Phil-obed/Industrial-Inspection-Bot/Programs/Dashboard/images/image.png

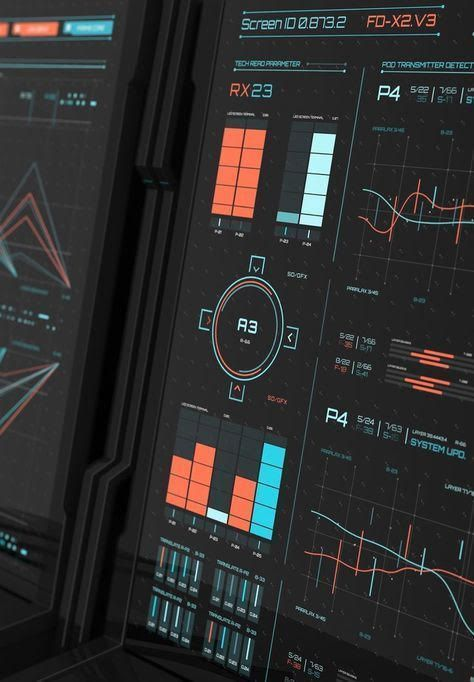
Programs/Dashboard/images/image.png
