Phil-obed/Industrial-Inspection-Bot/README.md

download TINYGPS++ library for successful compilation
