Phil-obed/Industrial-Inspection-Bot/Documents/COVER.docx

University of Energy and Natural Resources

Department of Computer and Electrical Engineering

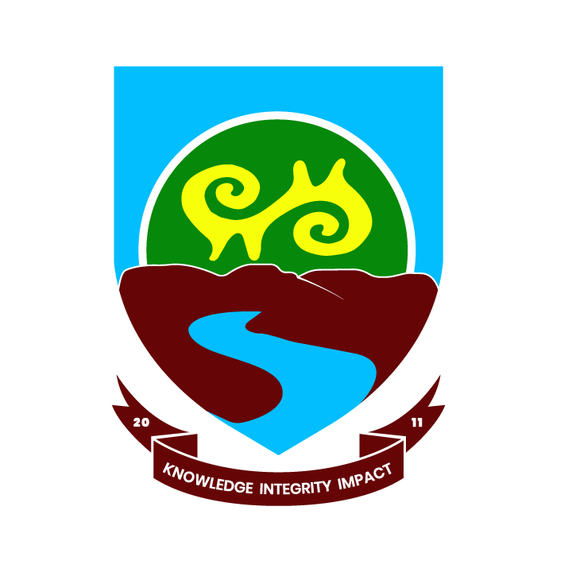
[picture p21: figure]

Bsc Electrical and Electronics Engineering

University of Energy and Natural Resources

Autonomous Robot for Motor Heat Anomalies and Gas Leak Detection in Thermal Power Plants

Philemon Obed Obeng - UEB0900121

Benjamin Asare - UEB0900121

Evans Tetteh - UEB0900121

Akwasi Frimpong Agyekum - UEB0900521
