Phil-obed/Industrial-Inspection-Bot/Documents/final.pdf

# Autonomous Robot for

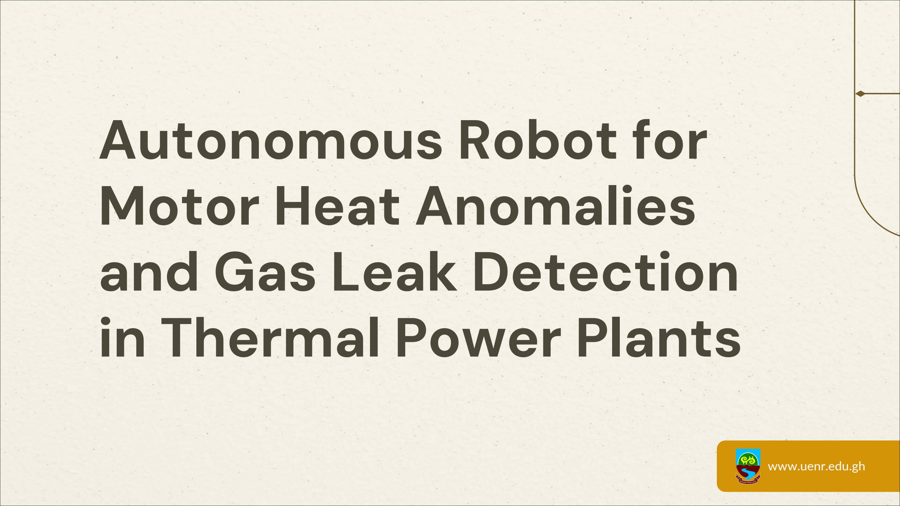
[picture p22: page 1]

# Motor Heat Anomalies and Gas Leak Detection in Thermal Power Plants

www.uenr.edu.gh

03

05

02

### Objectives

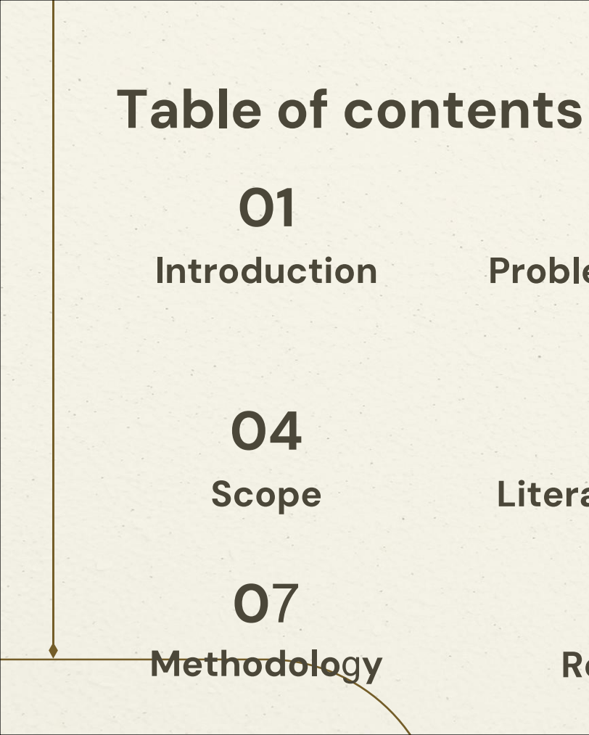
[picture p23: figure]
Table of contents 01; Introduction; Scope 07; Methodology

### Literature Review

### Problem Statement

www.uenr.edu.gh

06

### Progress

08

### References

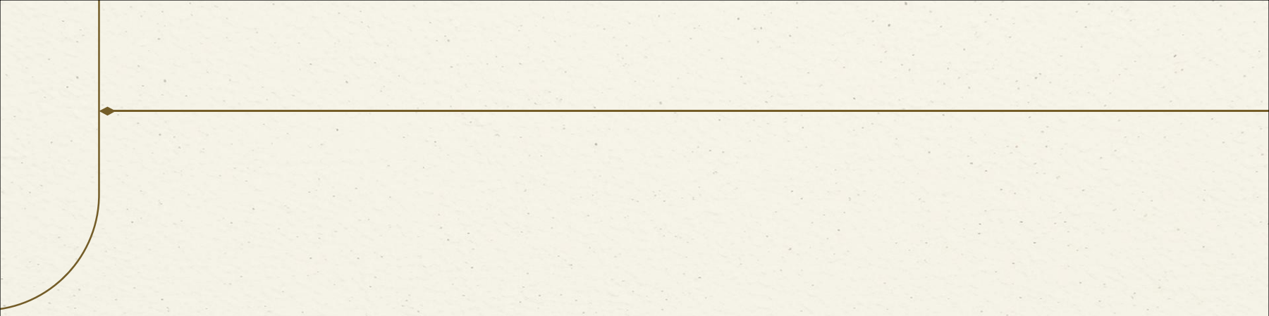
[picture p24: figure]

# Introduction

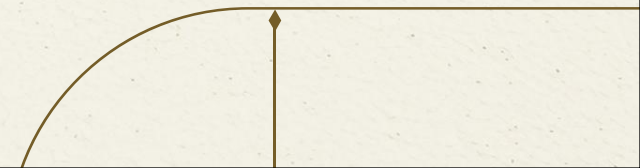
[picture p25: figure]

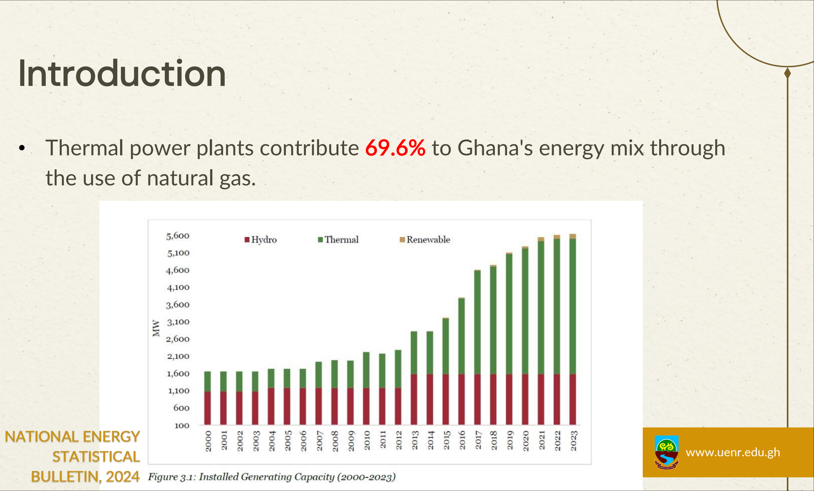
[picture p26: figure]
Introduction; the use of natural gas.; www.uenr.edu.gh

- Thermal power plants contribute 69.6% to Ghana's energy mix through

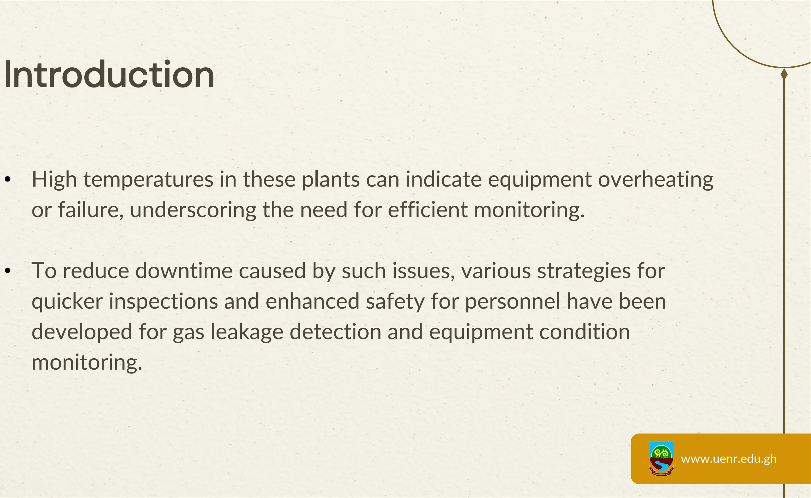
[picture p27: figure]
Introduction; monitoring.; www.uenr.edu.gh

- High temperatures in these plants can indicate equipment overheating or failure, underscoring the need for efficient monitoring. • To reduce downtime caused by such issues, various strategies for

quicker inspections and enhanced safety for personnel have been developed for gas leakage detection and equipment condition

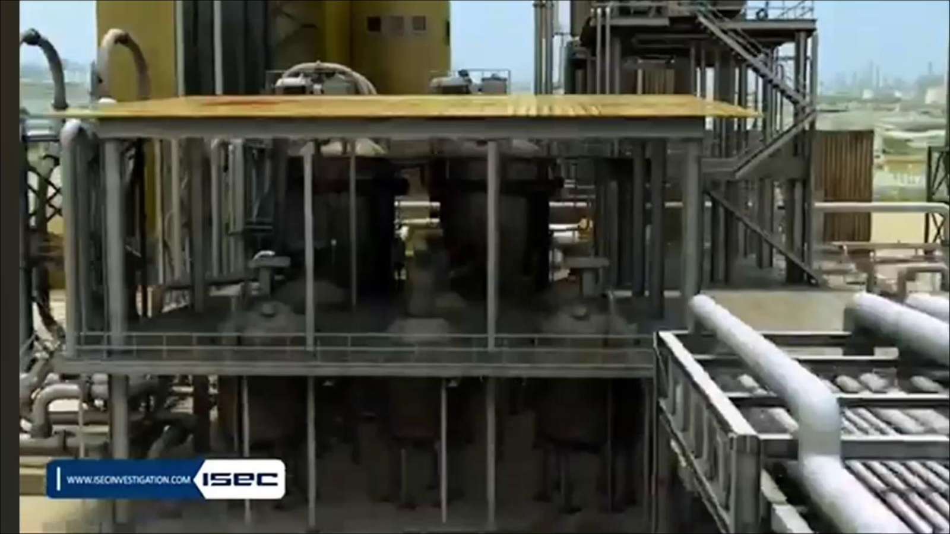
[picture p28: page 6]
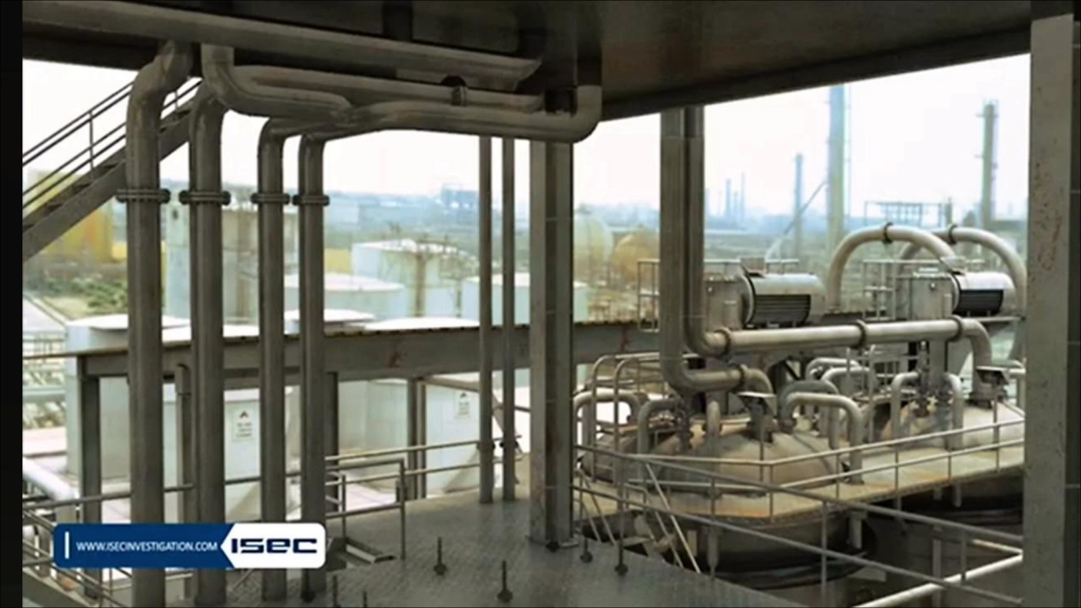
[picture p29: page 7]
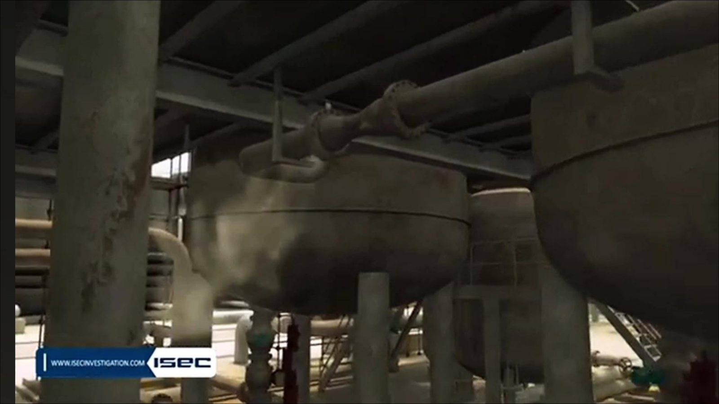
[picture p30: page 8]
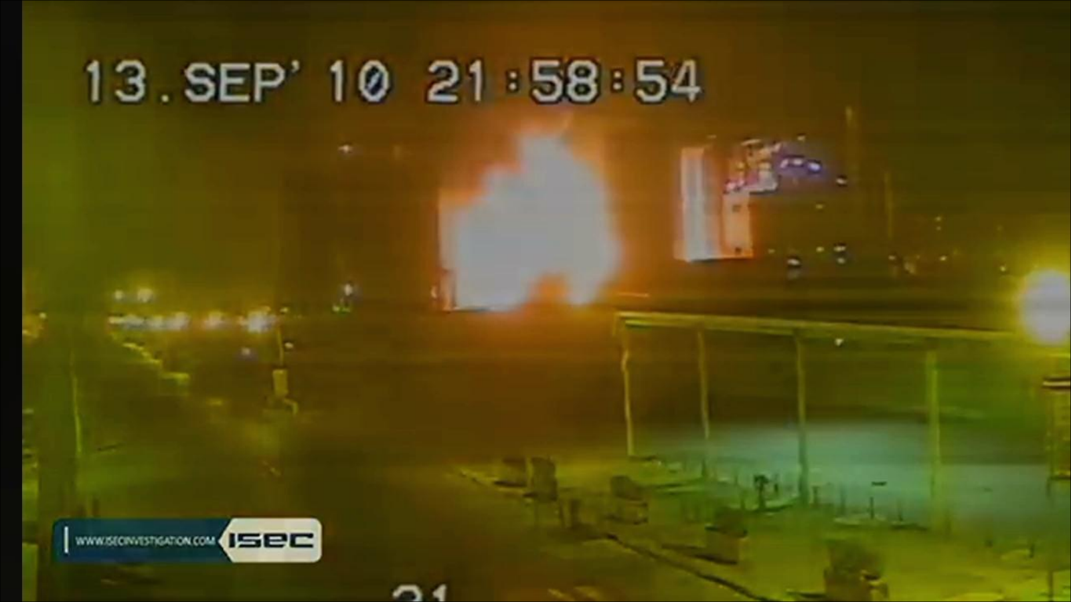
[picture p31: page 9]

# Problem Statement

- Our analysis reveals the dangers of personnel-led monitoring in thermal power plants, where gas leakages and thermal irregularities can occur
- Monitoring the conditions of industrial motors is crucial and can cause serious risks posed by its absence. • Gas leakages are significant contributors to fire incidents, endangering

both equipment and personnel safety. • Abnormal thermal conditions in industrial motors indicate potential

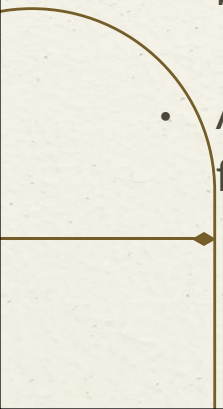
[picture p32: figure]

failures, leading to costly downtimes if not addressed on time. www.uenr.edu.gh

# Objectives

# Objectives

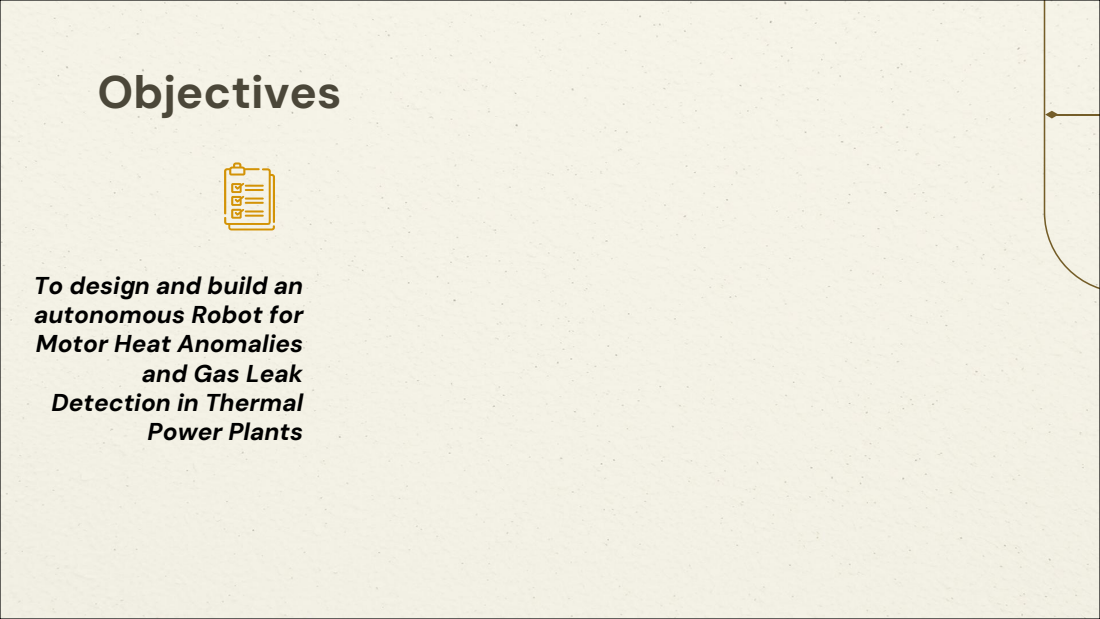
[picture p33: page 13]

To design and build an
autonomous Robot for
Motor Heat Anomalies
Detection in Thermal

and Gas Leak
Power Plants

# Objectives

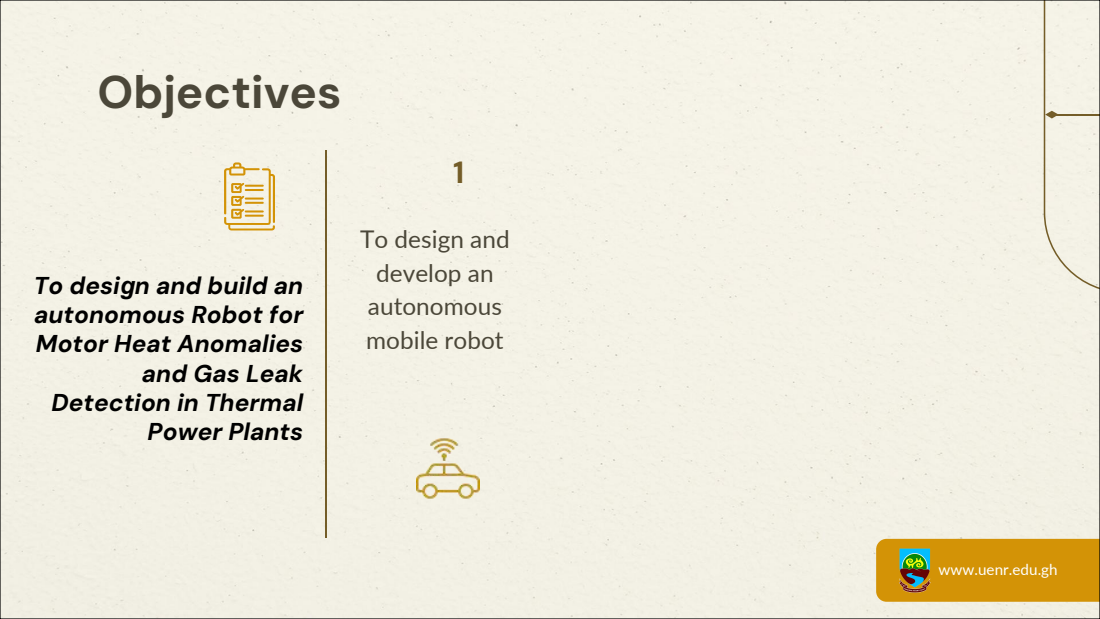
[picture p34: page 14]

To design and
develop an
autonomous
mobile robot

To design and build an
autonomous Robot for
Motor Heat Anomalies
Detection in Thermal

and Gas Leak
Power Plants

www.uenr.edu.gh

# Objectives

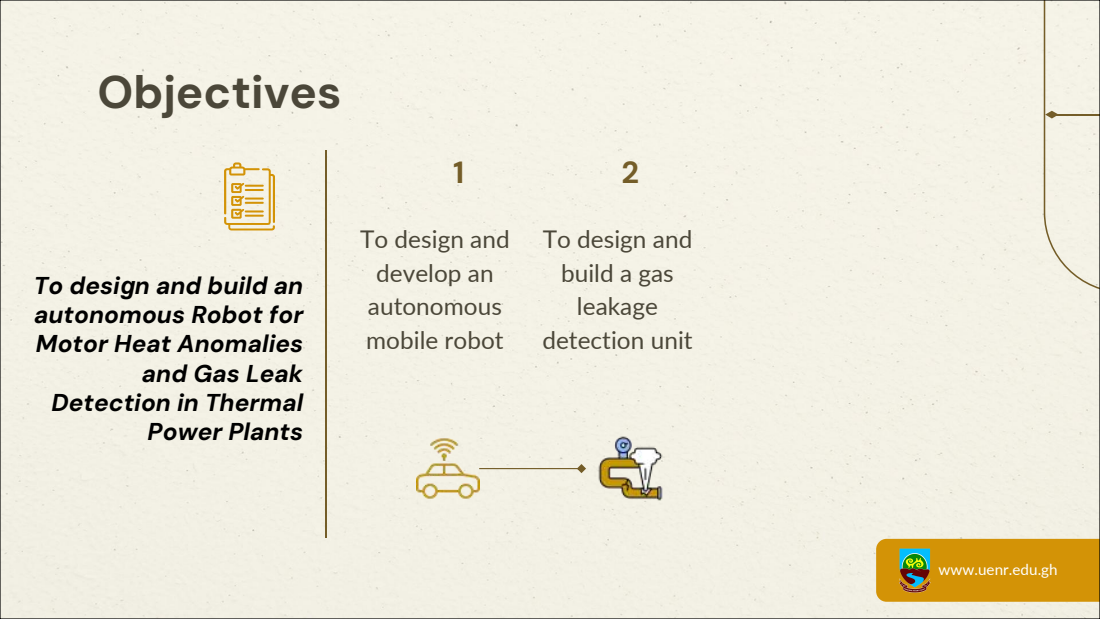
[picture p35: page 15]

To design and
develop an
autonomous
mobile robot

build a gas
leakage
detection unit

To design and build an
autonomous Robot for
Motor Heat Anomalies
Detection in Thermal

and Gas Leak
Power Plants

www.uenr.edu.gh

# Objectives

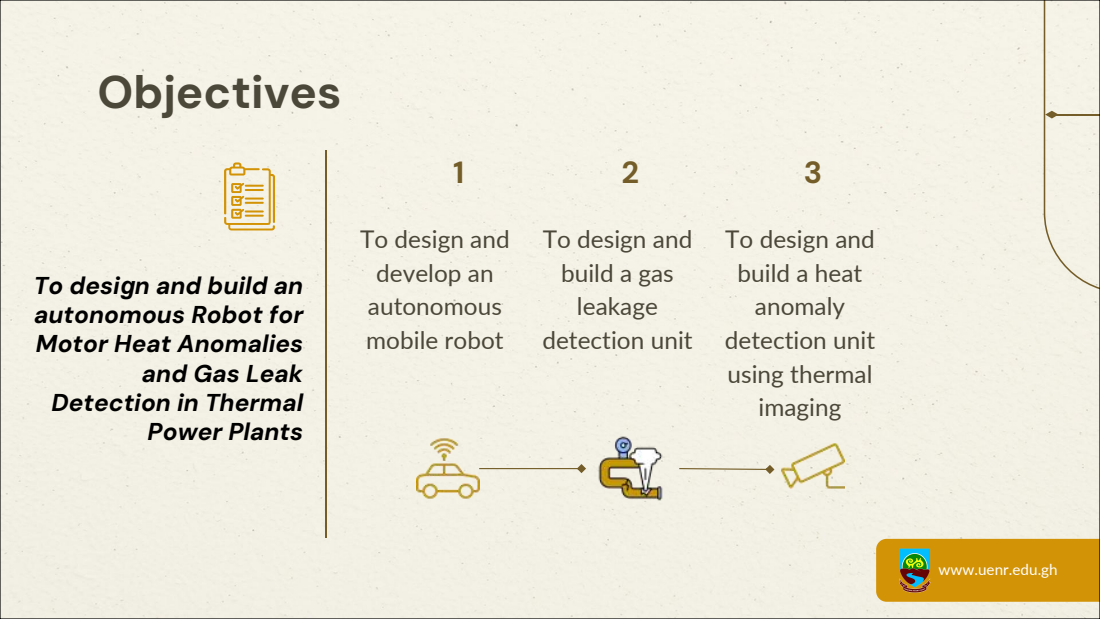
[picture p36: page 16]

To design and
develop an
autonomous
mobile robot

build a gas
leakage
detection unit

build a heat
anomaly
using thermal
imaging

To design and build an
autonomous Robot for
Motor Heat Anomalies
Detection in Thermal

and Gas Leak
Power Plants

www.uenr.edu.gh

# Objectives

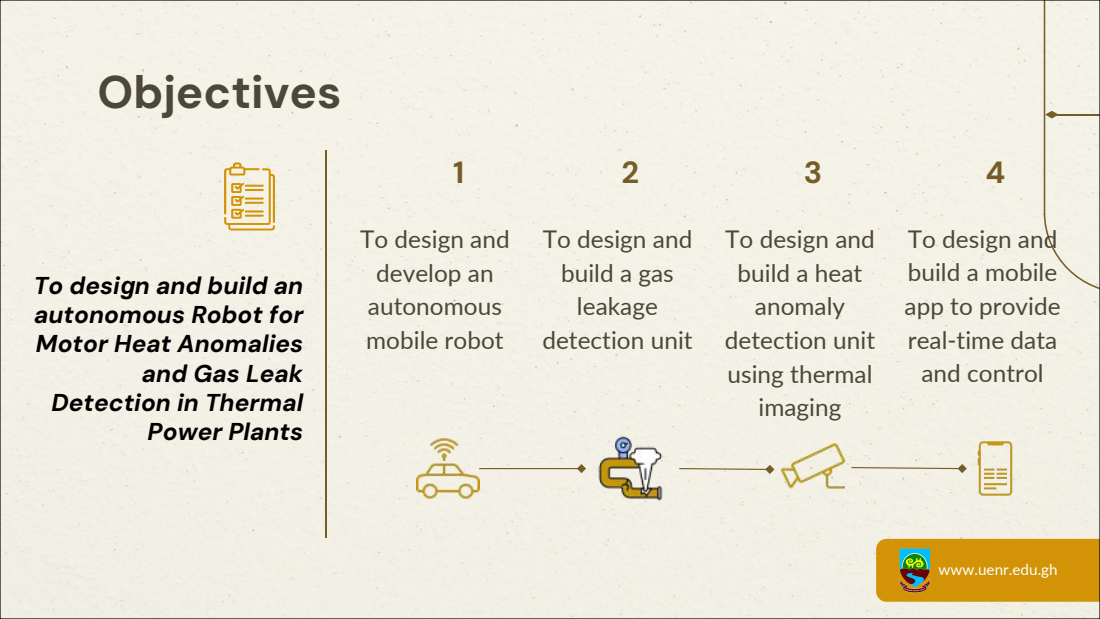
[picture p37: page 17]

To design and
develop an
autonomous
mobile robot

build a gas
leakage
detection unit

build a heat
anomaly
using thermal
imaging

build a mobile
app to provide
real-time data
and control

To design and build an
autonomous Robot for
Motor Heat Anomalies
Detection in Thermal

and Gas Leak
Power Plants

www.uenr.edu.gh

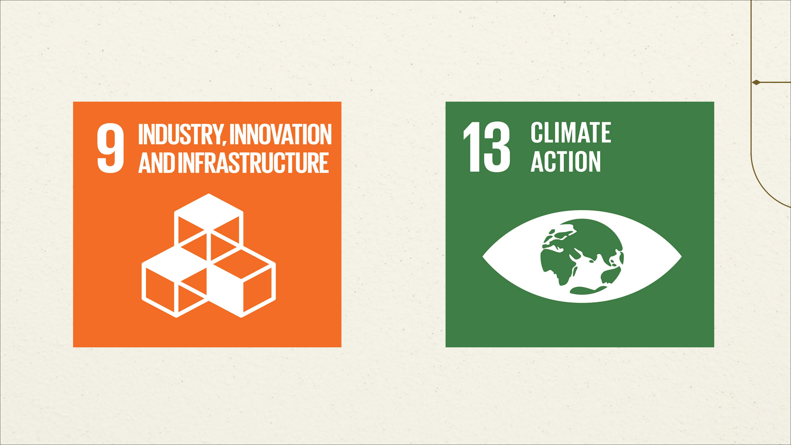
[picture p38: page 18]

# Scope of the Project

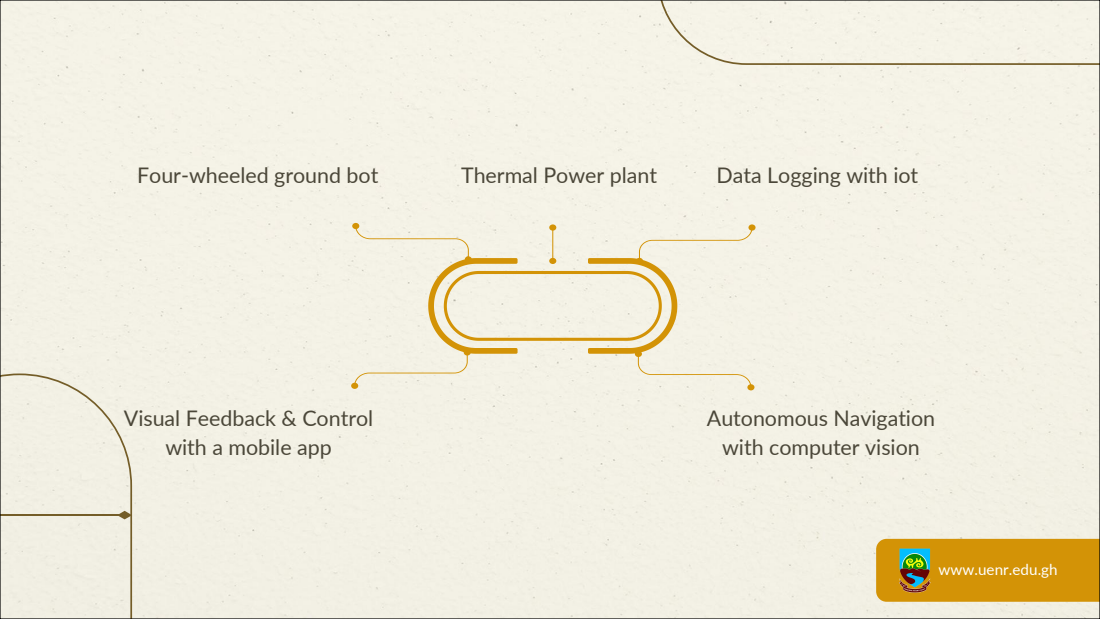
[picture p39: page 20]
Four-wheeled ground bot; Data Logging with iot

Thermal Power plant

Visual Feedback & Control
with a mobile app

Autonomous Navigation
with computer vision

www.uenr.edu.gh

# Literature Review

What existing research shows

AUTHOR(S),TITLE & YEAR | METHODOLOGY, STUDY SYSTEM, SIMULATION TOOL | RESULTS | COMMENTS/ DRAWBACKS Olivier Janssens et al 2017 Deep Learning for Infrared Thermal Image Based Machine Health Monitoring | i. | The objective of this paper is to investigate the possibility and how Convolutional Neural Networks (CNN) could be applied to infrared thermal video for automatically determining the condition of a machine. ii. They trained their model using deep networks and applied transfer learning. | i. | Feature learning 86.67% ii. | Feature engineering 80.00% | i. | Their results showed that CNNs could be used for detecting fault conditions in machines and its potential to improve online condition monitoring. ii. Their work however is stationary for the inspection hence applications will require more thermal cameras. This can be avoided by having a mobile robot navigate the plant.

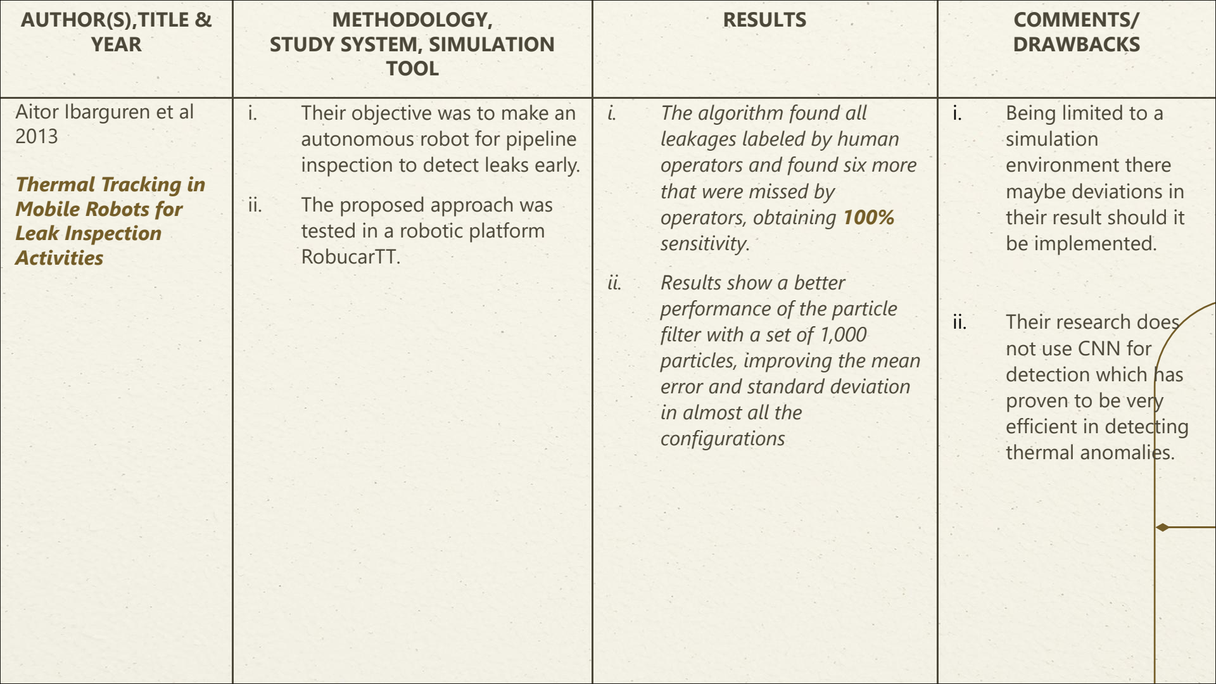
[picture p40: figure]
AUTHOR(S),TITLE & YEAR; METHODOLOGY, STUDY SYSTEM, SIMULATION TOOL; RESULTS; COMMENTS/; DRAWBACKS; Aitor Ibarguren et al 2013; Thermal Tracking in Mobile Robots for Leak Inspection Activities; i. Their objective was to make an autonomous robot for pipeline; tested in a robotic platform RobucarTT.; i. The algorithm found all leakages labeled by human operators and found six more that were missed by operators, obtaining 100%; sensitivity. ii.; Results show a better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

inspection to detect leaks early. ii. The proposed approach was

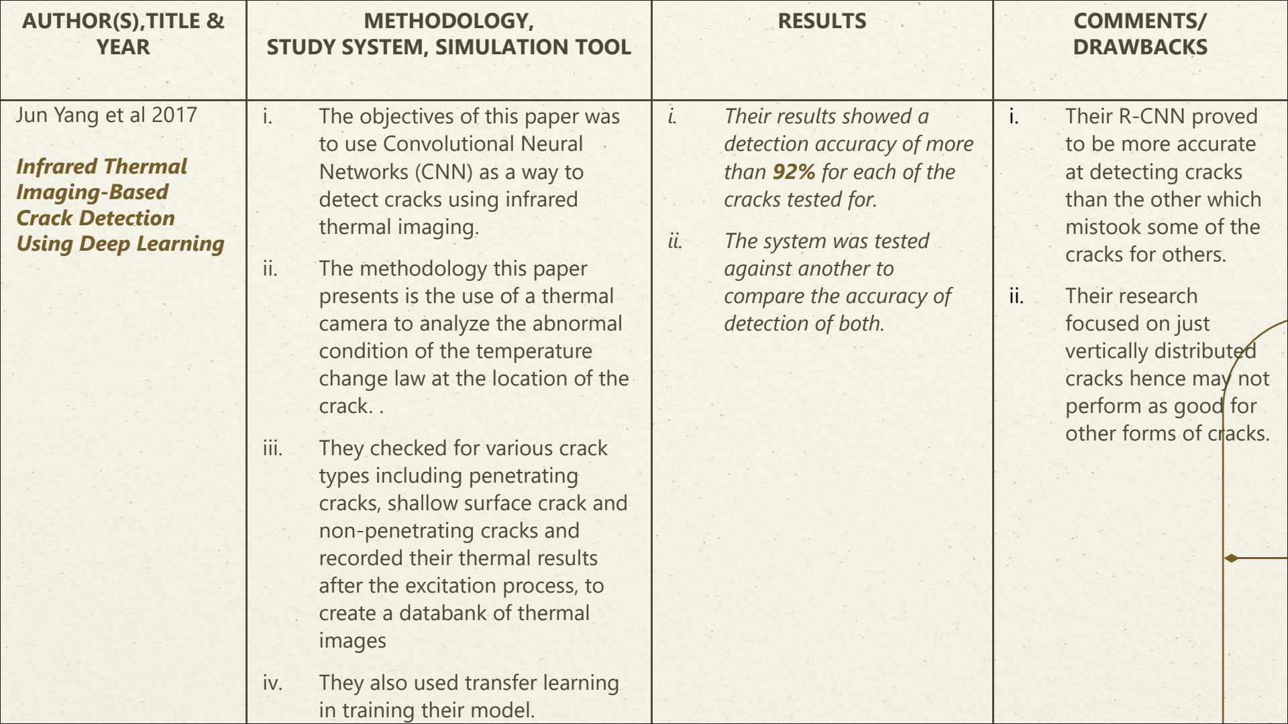
[picture p41: figure]
AUTHOR(S),TITLE & YEAR; METHODOLOGY, STUDY SYSTEM, SIMULATION TOOL; RESULTS; COMMENTS/; DRAWBACKS; Jun Yang et al 2017; Infrared Thermal Imaging-Based Crack Detection Using Deep Learning; i. The objectives of this paper was to use Convolutional Neural Networks (CNN) as a way to detect cracks using infrared; presents is the use of a thermal camera to analyze the abnormal condition of the temperature change law at the location of the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

thermal imaging. ii. The methodology this paper

crack. . iii. They checked for various crack

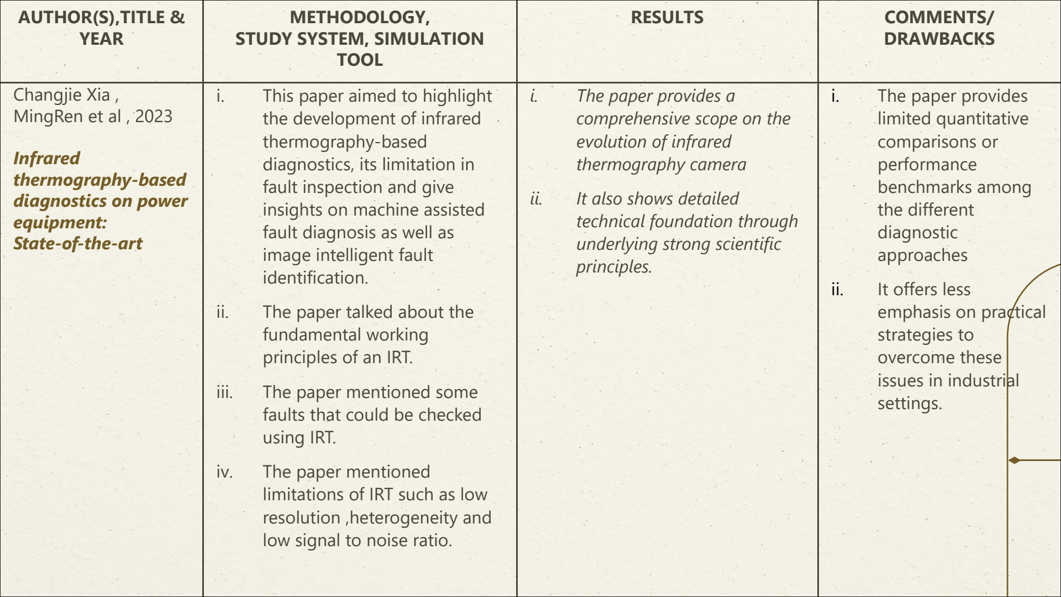
[picture p42: figure]
AUTHOR(S),TITLE & YEAR; METHODOLOGY, STUDY SYSTEM, SIMULATION TOOL; RESULTS; COMMENTS/; DRAWBACKS; Changjie Xia , MingRen et al , 2023; Infrared thermography-based diagnostics on power equipment: State-of-the-art; i. This paper aimed to highlight the development of infrared thermography-based diagnostics, its limitation in fault inspection and give insights on machine assisted fault diagnosis as well as image intelligent fault; fundamental working; faults that could be checked using IRT. iv. The paper mentioned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

identification. ii. The paper talked about the

principles of an IRT. iii. The paper mentioned some

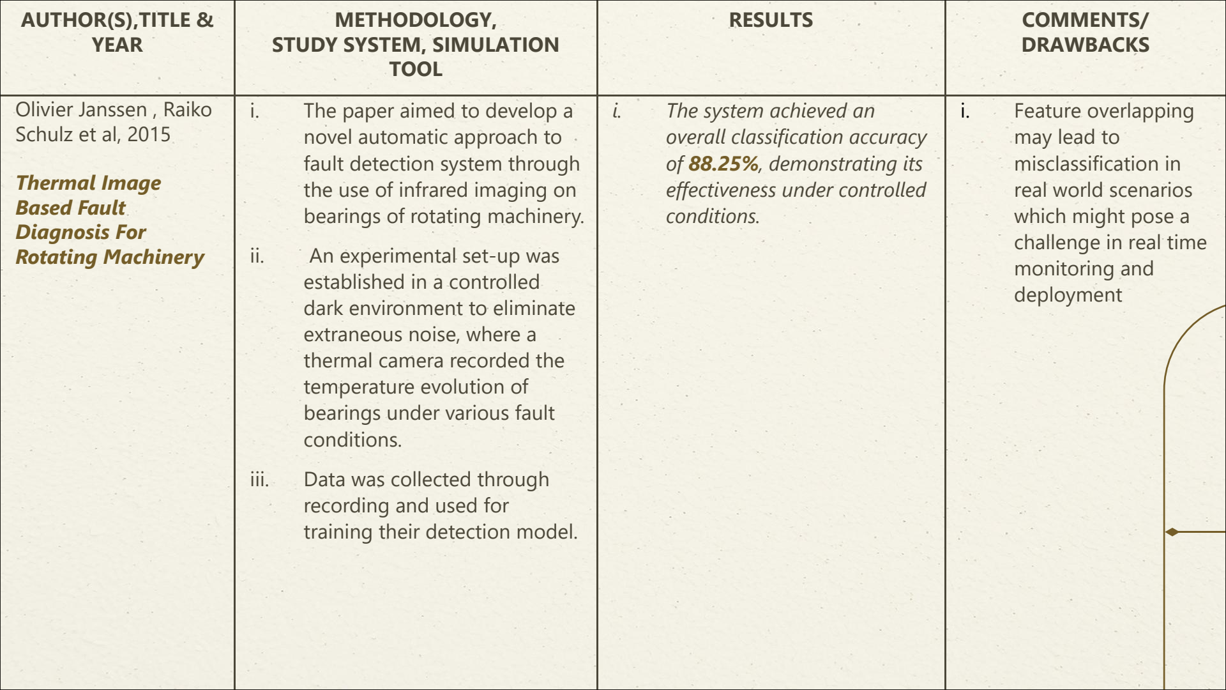
[picture p43: figure]
AUTHOR(S),TITLE & YEAR; METHODOLOGY, STUDY SYSTEM, SIMULATION TOOL; RESULTS; COMMENTS/; DRAWBACKS; Olivier Janssen , Raiko Schulz et al, 2015; Thermal Image Based Fault Diagnosis For Rotating Machinery; i. The paper aimed to develop a novel automatic approach to fault detection system through the use of infrared imaging on; bearings of rotating machinery. ii.; An experimental set-up was; established in a controlled dark environment to eliminate extraneous noise, where a thermal camera recorded the temperature evolution of bearings under various fault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

conditions. iii. Data was collected through

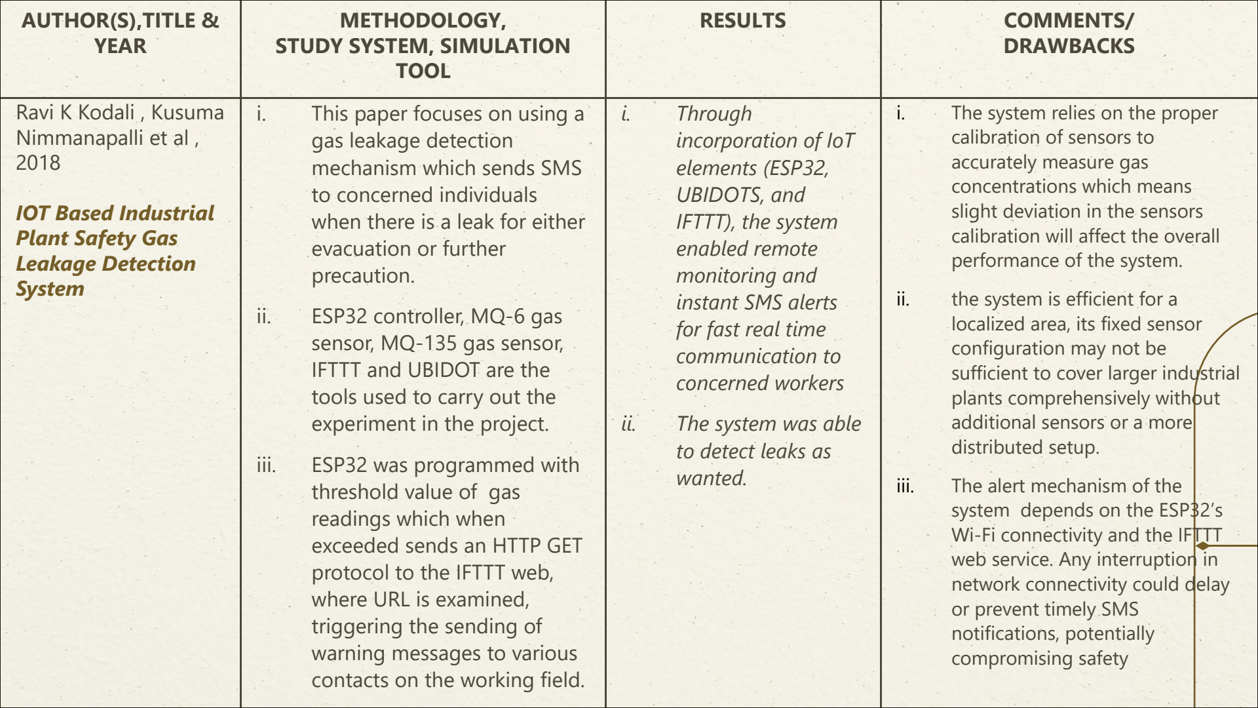
[picture p44: figure]
AUTHOR(S),TITLE & YEAR; METHODOLOGY, STUDY SYSTEM, SIMULATION TOOL; RESULTS; COMMENTS/; DRAWBACKS; Ravi K Kodali , Kusuma Nimmanapalli et al , 2018; IOT Based Industrial Plant Safety Gas Leakage Detection System; i. This paper focuses on using a gas leakage detection mechanism which sends SMS to concerned individuals when there is a leak for either evacuation or further; tools used to carry out the; threshold value of gas readings which when exceeded sends an HTTP GET; warning messages to various contacts on the working field.; i. Through incorporation of IoT elements (ESP32, UBIDOTS, and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

precaution. ii. ESP32 controller, MQ-6 gas

sensor, MQ-135 gas sensor, IFTTT and UBIDOT are the

experiment in the project. iii. ESP32 was programmed with

protocol to the IFTTT web, where URL is examined, triggering the sending of performance of the system. ii. the system is efficient for a

distributed setup. iii. The alert mechanism of the

# Progress

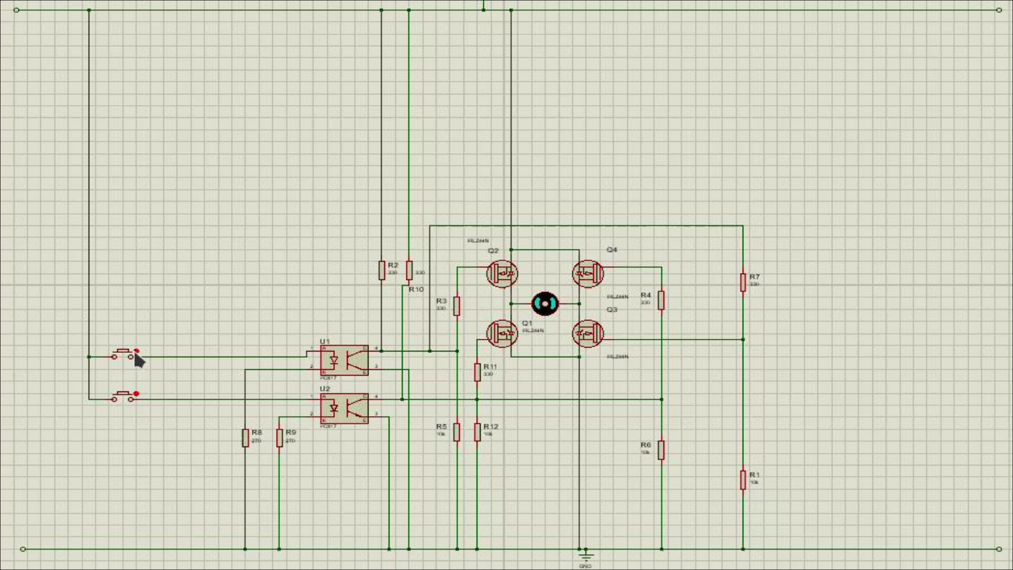
[picture p45: page 29]
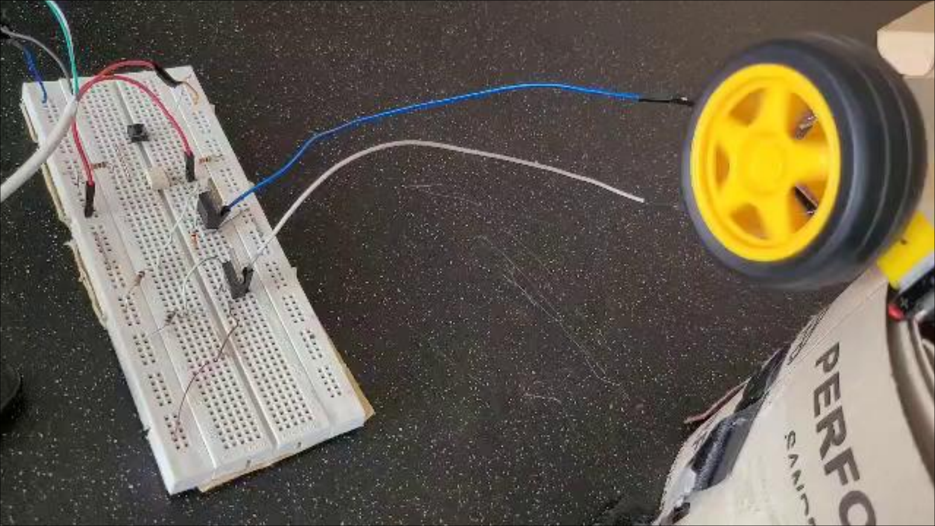
[picture p46: page 30]

# Methodology

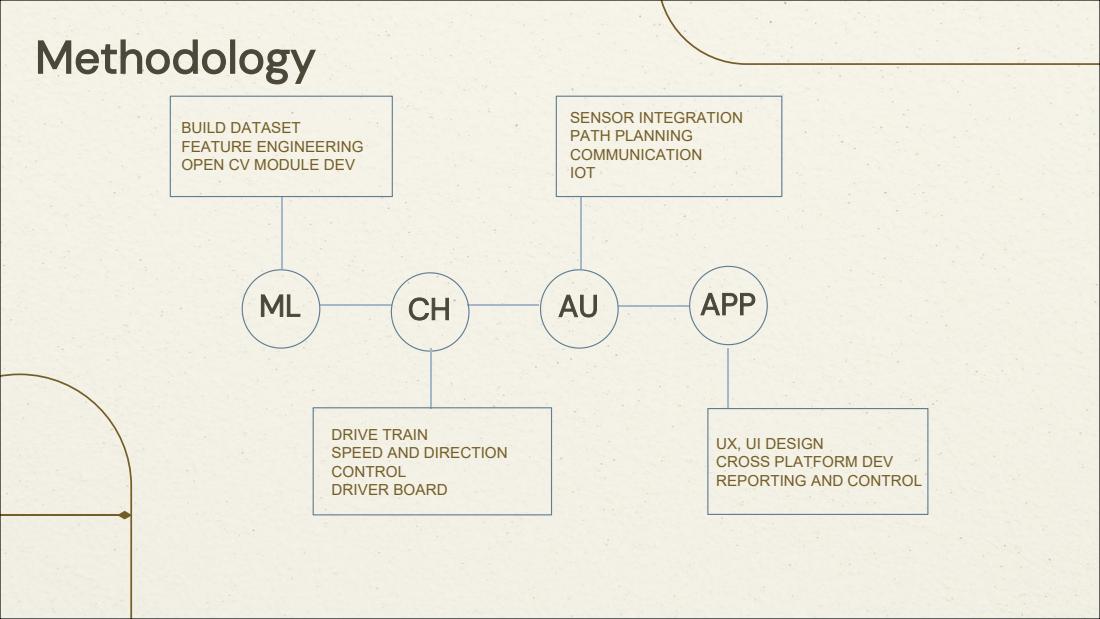
[picture p47: page 33]
SENSOR INTEGRATION PATH PLANNING COMMUNICATION IOT; APP

BUILD DATASET
FEATURE ENGINEERING
OPEN CV MODULE DEV

DRIVE TRAIN
SPEED AND DIRECTION
CONTROL
DRIVER BOARD

UX, UI DESIGN
CROSS PLATFORM DEV
REPORTING AND CONTROL

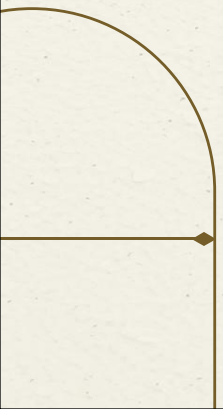
[picture p48: figure]

SENSOR & AI
INTEGRATION

UI &
COMMUNICATION
SYSTEM

TESTING &
DEPLOYMENT

# Next Steps

# References

National Energy Statistical Bulletin, 2024

Olivier Janssens et al 2017
Deep Learning for Infrared Thermal Image Based Machine Health Monitoring

Aitor Ibarguren et al 2013
Thermal Tracking in Mobile Robots for Leak Inspection Activities

Changjie Xia , MingRen et al , 2023
Infrared thermography‐ based diagnostics on power equipment: State‐ of‐ the‐ art

Ravi K Kodali , Kusuma Nimmanapalli et al , 2018
IOT Based Industrial Plant Safety Gas Leakage Detection System

Jun Yang et al 2017
Infrared Thermal Imaging-Based Crack Detection Using Deep Learning

Olivier Janssen , Raiko Schulz et al, 2015
Thermal Image Based Fault Diagnosis For Rotating Machinery

# Thank

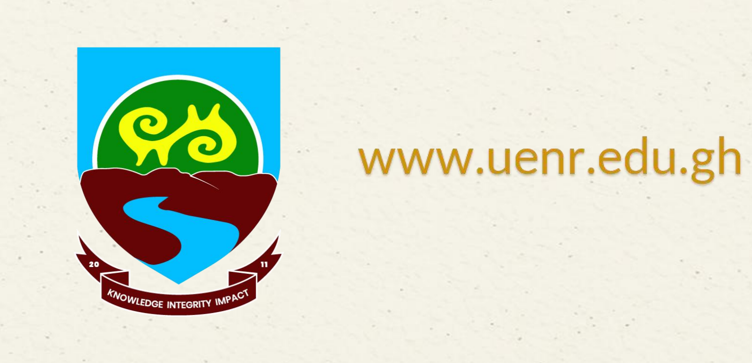
[picture p49: figure]

# You!
