Phil-obed/Industrial-Inspection-Bot/circuits/pcb/HAT/Screenshot 2025-09-14 121545.png

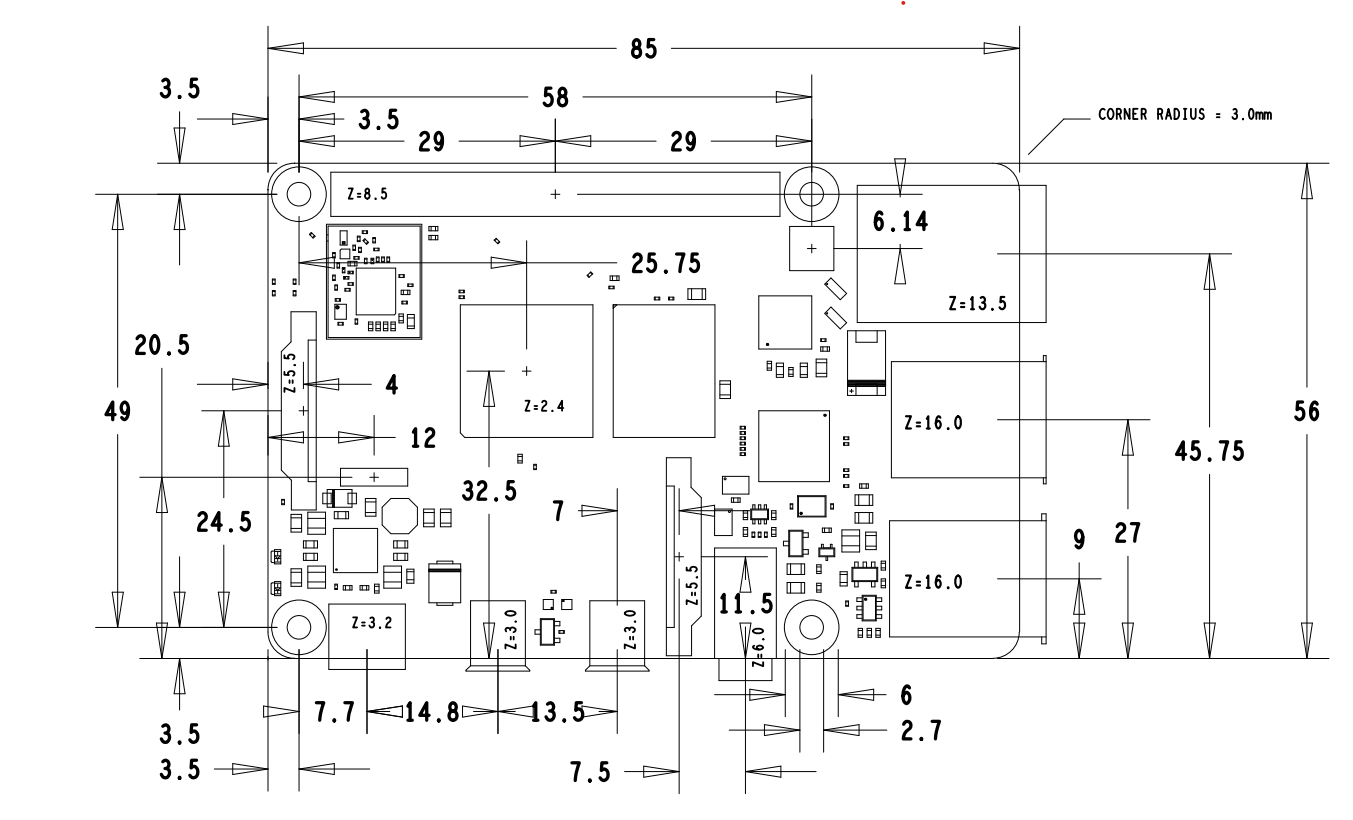
circuits/pcb/HAT/Screenshot 2025-09-14 121545.png
