Phil-obed/Industrial-Inspection-Bot/Programs/block diagram.jpg

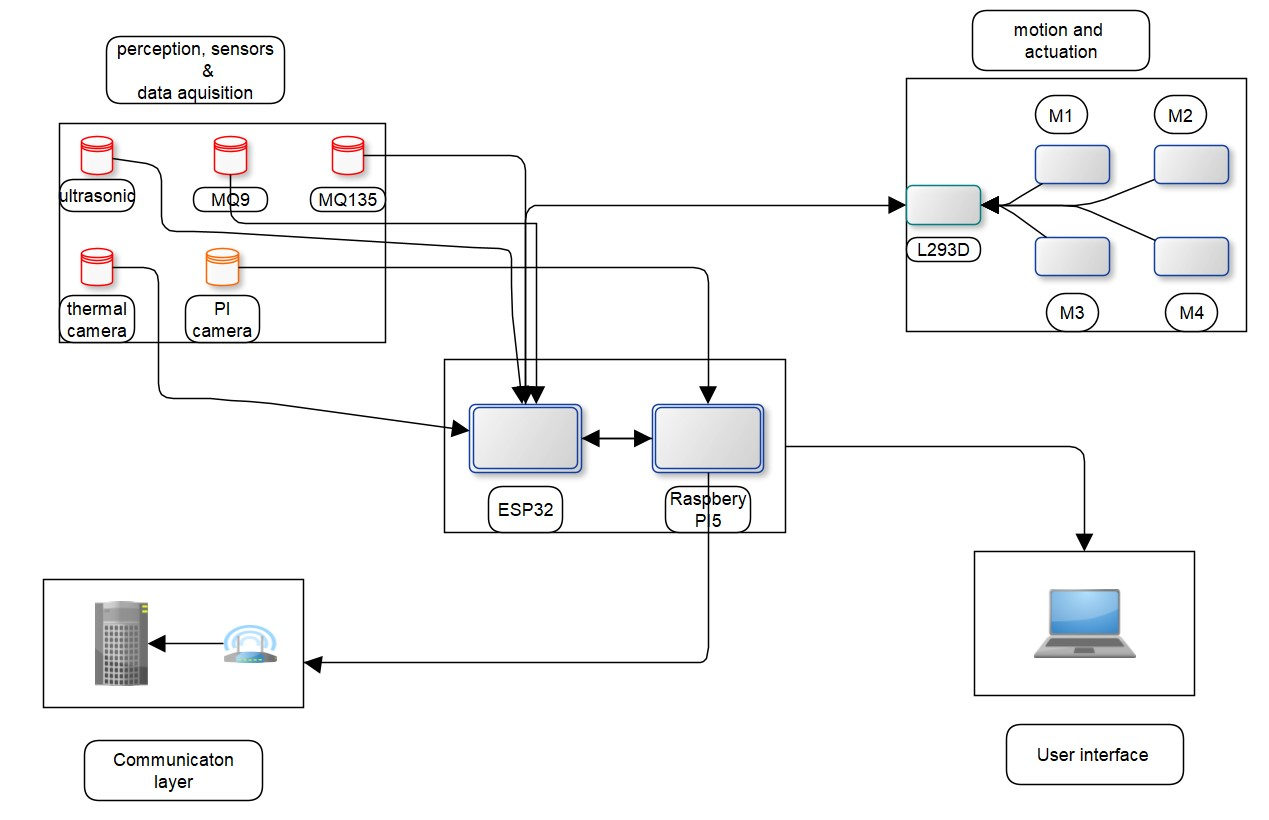
Programs/block diagram.jpg
