Phil-obed/Industrial-Inspection-Bot/Programs/Dashboard/images/_.jpeg

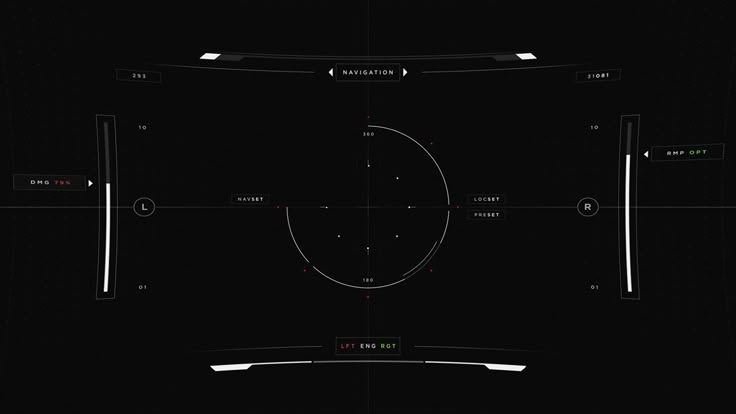
Programs/Dashboard/images/_.jpeg
