Phil-obed/Industrial-Inspection-Bot/Programs/Dashboard/images/bot.png

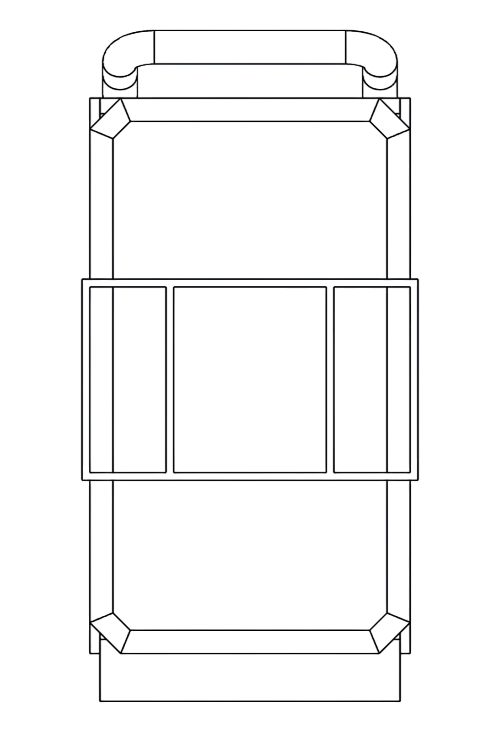
Programs/Dashboard/images/bot.png
