Phil-obed/Industrial-Inspection-Bot/Programs/Dashboard/images/wheels.png

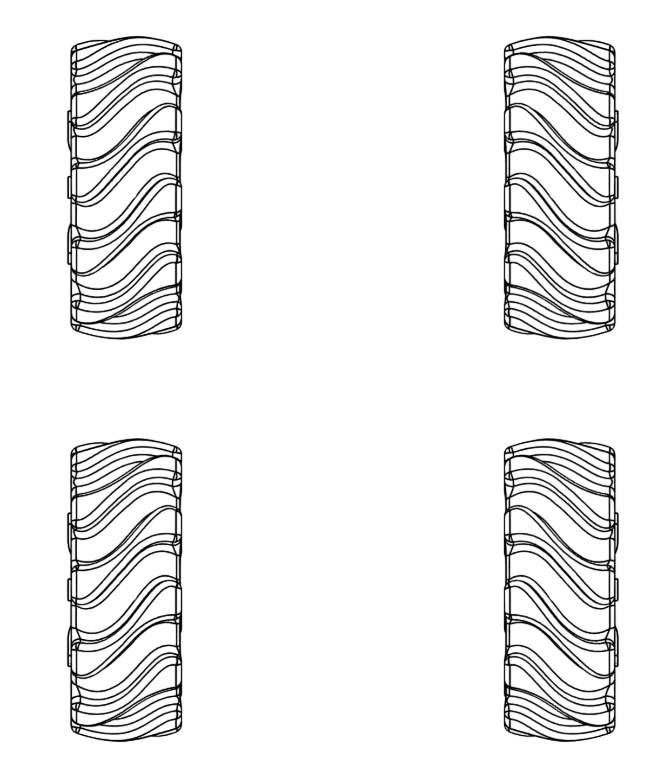
Programs/Dashboard/images/wheels.png
