Phil-obed/Industrial-Inspection-Bot/(list of files, drawings)

Other design files:
circuits/pcb/HAT/HAT_1/freerouting.dsn
circuits/pcb/HAT/HAT_1/temp-freerouting.dsn
circuits/pcb/HAT/HAT_2/freerouting.dsn
circuits/pcb/HAT/HAT_2/temp-freerouting.dsn
circuits/pcb/HAT/routes/HAT_1.dsn
