Phil-obed/Industrial-Inspection-Bot/circuits/pcb/HAT/HAT_1/HAT_1.kicad_pcb

## KiCad design circuits/pcb/HAT/HAT_1/HAT_1.kicad_pcb (2025-09-16)

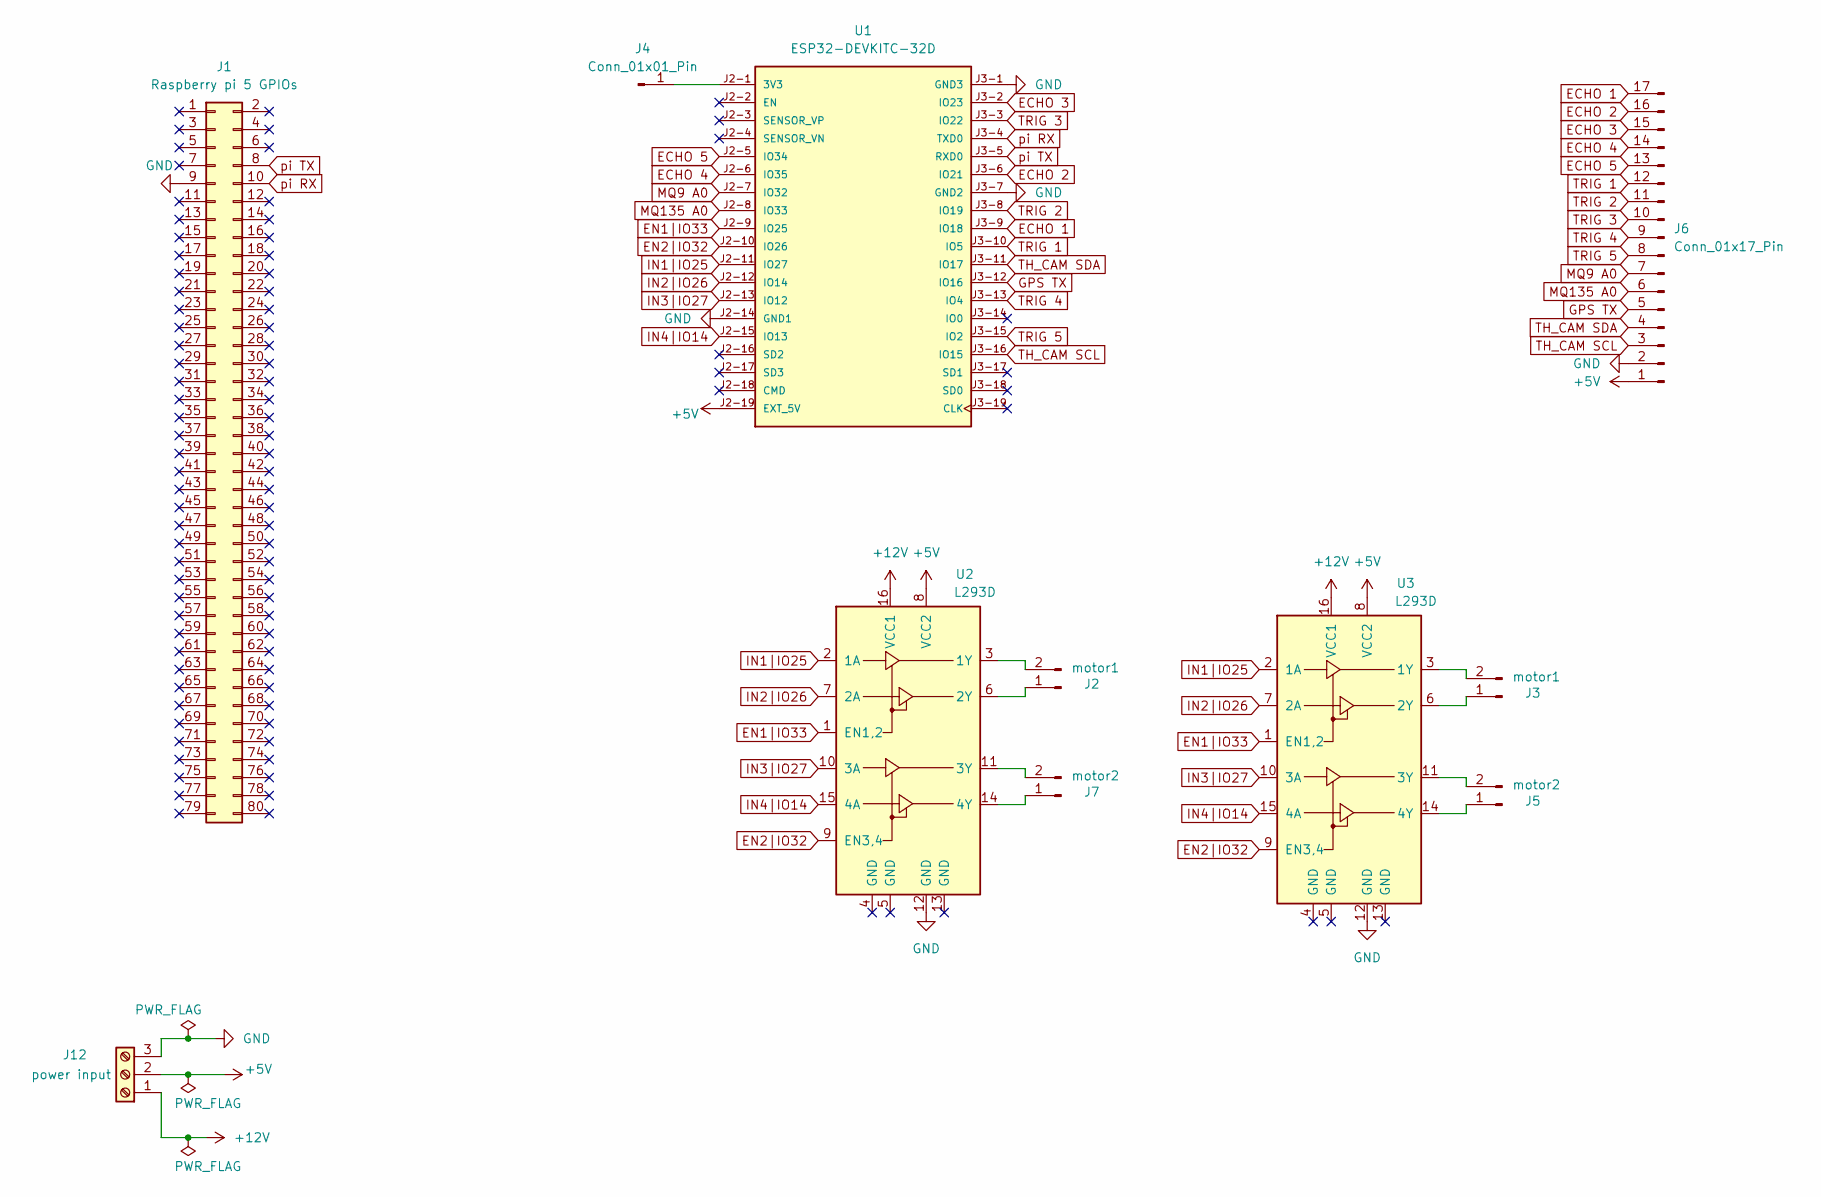
[picture p60: schematic HAT_1.kicad_sch, Industrial Inspection Bot]

Parts:
J1: Raspberry pi 5 GPIOs; PinHeader_2x20_P2.54mm_Vertical
J2, J3: motor1; PinHeader_1x02_P2.54mm_Vertical
J4: Conn_01x01_Pin; PinHeader_1x01_P2.54mm_Vertical
J5, J7: motor2; PinHeader_1x02_P2.54mm_Vertical
J6: Conn_01x17_Pin; PinHeader_1x17_P2.54mm_Vertical
J12: power input; TerminalBlock_CUI_TB007-508-03_1x03_P5.08mm_Horizontal
U1: ESP32-DEVKITC-32D; MODULE_ESP32-DEVKITC-32D; PARTREV V4
U2, U3: L293D; DIP-16_W7.62mm

Connections:
+5V: J6.1, J12.2, U1.J2-19 (EXT_5V), U2.8 (VCC2), U3.8 (VCC2)
+12V: J12.1, U2.16 (VCC1), U3.16 (VCC1)
ECHO 1: J6.17, U1.J3-9 (IO18)
ECHO 2: J6.16, U1.J3-6 (IO21)
ECHO 3: J6.15, U1.J3-2 (IO23)
ECHO 4: J6.14, U1.J2-6 (IO35)
ECHO 5: J6.13, U1.J2-5 (IO34)
EN1|IO33: U1.J2-9 (IO25), U2.1 (EN1,2), U3.1 (EN1,2)
EN2|IO32: U1.J2-10 (IO26), U2.9 (EN3,4), U3.9 (EN3,4)
GND: J1.9, J6.2, J12.3, U1.J2-14 (GND1), U1.J3-1 (GND3), U1.J3-7 (GND2), U2.12 (GND), U3.12 (GND)
GPS TX: J6.5, U1.J3-12 (IO16)
IN1|IO25: U1.J2-11 (IO27), U2.2 (1A), U3.2 (1A)
IN2|IO26: U1.J2-12 (IO14), U2.7 (2A), U3.7 (2A)
IN3|IO27: U1.J2-13 (IO12), U2.10 (3A), U3.10 (3A)
IN4|IO14: U1.J2-15 (IO13), U2.15 (4A), U3.15 (4A)
MQ9 A0: J6.7, U1.J2-7 (IO32)
MQ135 A0: J6.6, U1.J2-8 (IO33)
unnamed: J2.1, U2.6 (2Y)
unnamed: J2.2, U2.3 (1Y)
unnamed: J3.1, U3.6 (2Y)
unnamed: J3.2, U3.3 (1Y)
unnamed: J4.1, U1.J2-1 (3V3)
unnamed: J5.1, U3.14 (4Y)
unnamed: J5.2, U3.11 (3Y)
unnamed: J7.1, U2.14 (4Y)
unnamed: J7.2, U2.11 (3Y)
TH_CAM SCL: J6.3, U1.J3-16 (IO15)
TH_CAM SDA: J6.4, U1.J3-11 (IO17)
TRIG 1: J6.12, U1.J3-10 (IO5)
TRIG 2: J6.11, U1.J3-8 (IO19)
TRIG 3: J6.10, U1.J3-3 (IO22)
TRIG 4: J6.9, U1.J3-13 (IO4)
TRIG 5: J6.8, U1.J3-15 (IO2)
pi RX: J1.10, U1.J3-4 (TXD0)
pi TX: J1.8, U1.J3-5 (RXD0)

Board: 2 copper layers, 11 parts (1 on the bottom side), 35 nets, no tracks yet.
