Phil-obed/Industrial-Inspection-Bot/circuits/pcb/HAT/HAT_2/HAT_2.kicad_pcb

## KiCad design circuits/pcb/HAT/HAT_2/HAT_2.kicad_pcb (2025-09-14)

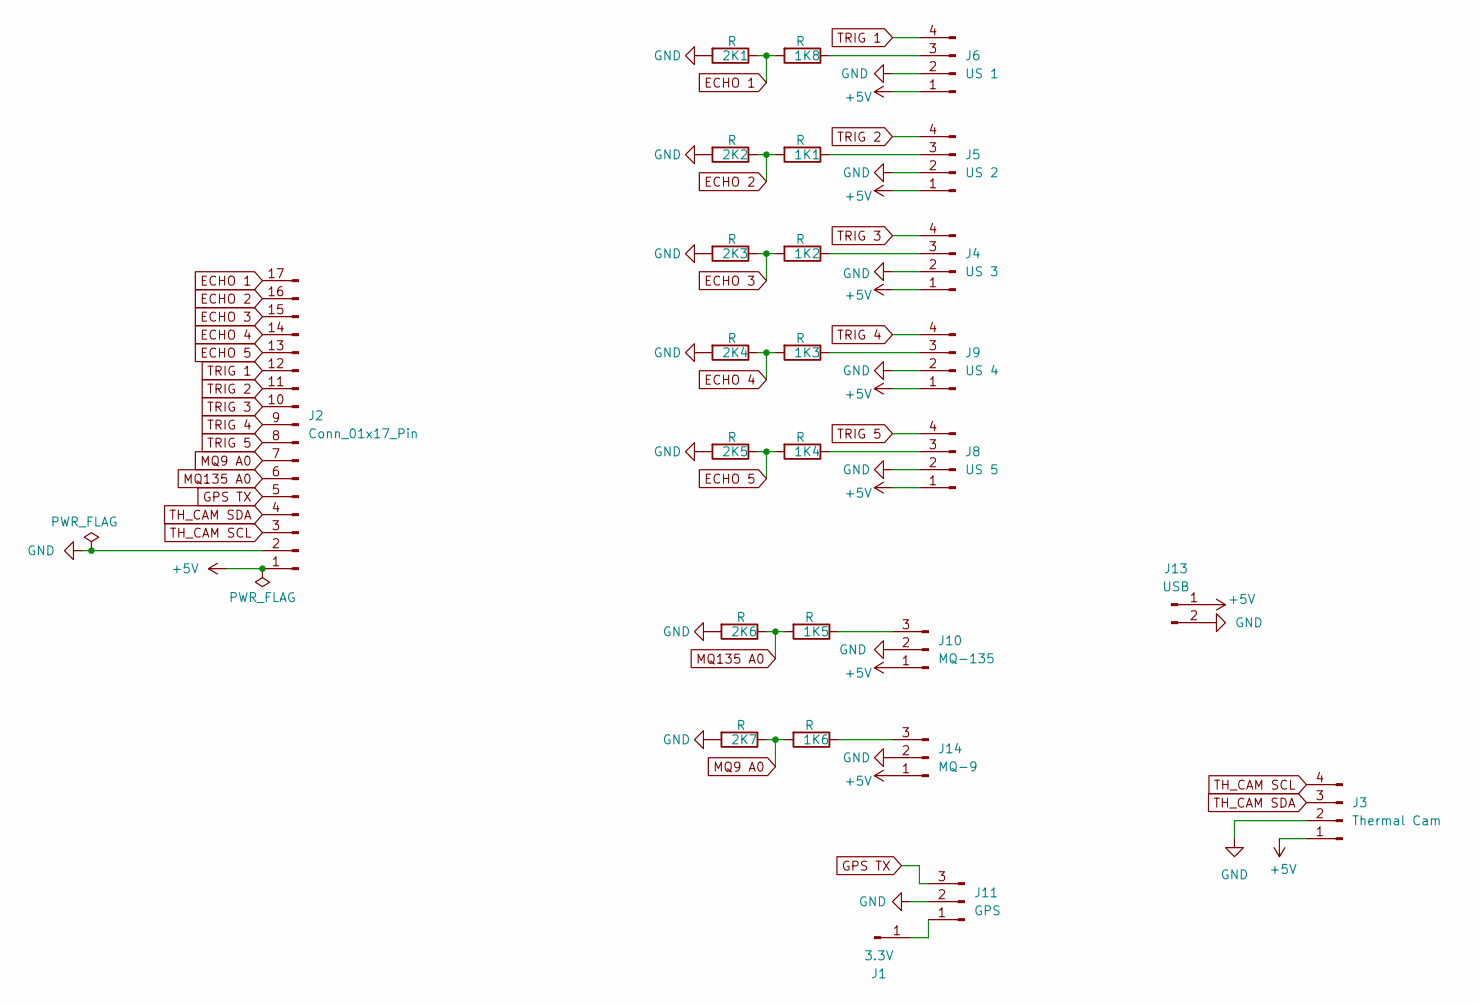
[picture p61: schematic HAT_2.kicad_sch]

Parts:
1K1, 1K2, 1K3, 1K4, 1K5, 1K6, 1K8, 2K1, 2K2, 2K3, 2K4, 2K5, 2K6, 2K7: R; R_Axial_DIN0207_L6.3mm_D2.5mm_P7.62mm_Horizontal
J1: 3.3V; PinHeader_1x01_P2.54mm_Vertical
J2: Conn_01x17_Pin; PinHeader_1x17_P2.54mm_Vertical
J3: Thermal Cam; PinHeader_1x04_P2.54mm_Vertical
J4: US 3; PinHeader_1x04_P2.54mm_Vertical
J5: US 2; PinHeader_1x04_P2.54mm_Vertical
J6: US 1; PinHeader_1x04_P2.54mm_Vertical
J8: US 5; PinHeader_1x04_P2.54mm_Vertical
J9: US 4; PinHeader_1x04_P2.54mm_Vertical
J10: MQ-135; PinHeader_1x03_P2.54mm_Vertical
J11: GPS; PinHeader_1x03_P2.54mm_Vertical
J13: USB; PinHeader_1x02_P2.54mm_Vertical
J14: MQ-9; PinHeader_1x03_P2.54mm_Vertical

Connections:
+5V: J2.1, J3.1, J4.1, J5.1, J6.1, J8.1, J9.1, J10.1, J13.1, J14.1
ECHO 1: 1K8.2, 2K1.1, J2.17
ECHO 2: 1K1.2, 2K2.1, J2.16
ECHO 3: 1K2.2, 2K3.1, J2.15
ECHO 4: 1K3.2, 2K4.1, J2.14
ECHO 5: 1K4.2, 2K5.1, J2.13
GND: 2K1.2, 2K2.2, 2K3.2, 2K4.2, 2K5.2, 2K6.2, 2K7.2, J2.2, J3.2, J4.2, J5.2, J6.2, J8.2, J9.2, J10.2, J11.2, J13.2, J14.2
GPS TX: J2.5, J11.3
MQ9 A0: 1K6.2, 2K7.1, J2.7
MQ135 A0: 1K5.2, 2K6.1, J2.6
unnamed: J1.1, J11.1
unnamed: 1K2.1, J4.3
unnamed: 1K1.1, J5.3
unnamed: 1K8.1, J6.3
unnamed: 1K4.1, J8.3
unnamed: 1K3.1, J9.3
unnamed: 1K5.1, J10.3
unnamed: 1K6.1, J14.3
TH_CAM SCL: J2.3, J3.4
TH_CAM SDA: J2.4, J3.3
TRIG 1: J2.12, J6.4
TRIG 2: J2.11, J5.4
TRIG 3: J2.10, J4.4
TRIG 4: J2.9, J9.4
TRIG 5: J2.8, J8.4

Board: 2 copper layers, 26 parts (0 on the bottom side), 25 nets, no tracks yet.
