Phil-obed/Industrial-Inspection-Bot/(commit log)

2025-08-29 Normalize line endings
    [HAT_1.kicad_pcb, HAT_1.kicad_sch, HAT_2.kicad_pcb, HAT_2.kicad_sch, freerouting.dsn]
2025-08-29 Add files via upload
    Thermal Camera codes
2025-09-10 print csv instead of serial output.
2025-09-17 main updated: Programs/main/ESP32/src/main.cpp
2025-09-17 ultrasonic visualization update
2025-09-17 ultrasonic visualization ui update(ease transitions for arcs and wedges)
